entropia/sublimelight-5g/README.md

# sublimelight-5g

5th generation of illumination devices for Entropia e.V
