entropia/sublimelight-5g/hardware/input_filter.kicad_pcb

## KiCad design hardware/input_filter.kicad_pcb (2020-02-28)

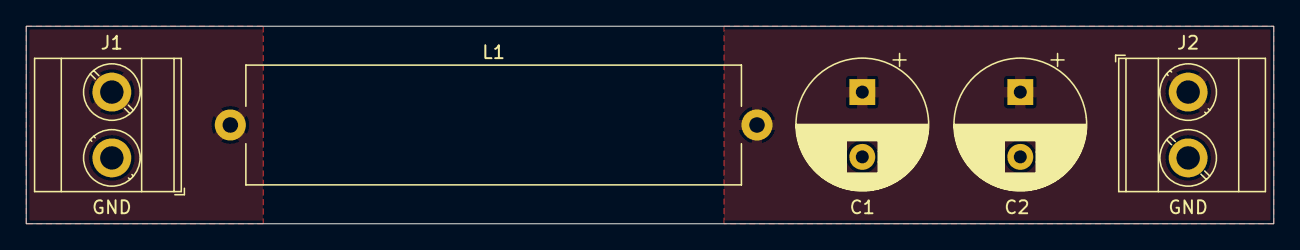
[picture p1: board input_filter.kicad_pcb from above]

Board: 2 copper layers, 96.3 x 15.2 mm, 5 parts (0 on the bottom side), 3 nets, no tracks yet.

Parts:
C1, C2: EEU-FP1V511B; CP_Radial_D10.0mm_P5.00mm
J1, J2: Conn_01x02; TerminalBlock_Phoenix_MKDS-3-2-5.08_1x02_P5.08mm_Horizontal
L1: 5252-RC; R_Axial_Power_L38.0mm_W9.0mm_P40.64mm

Connections:
/V_IN: J1.2, L1.1
/V_OUT: C1.1, C2.1, J2.1, L1.2
GND: C1.2, C2.2, J1.1, J2.2
