entropia/sublimelight-5g/hardware/sublimelight-5g.kicad_pcb

## KiCad design hardware/sublimelight-5g.kicad_pcb (2019-11-16)

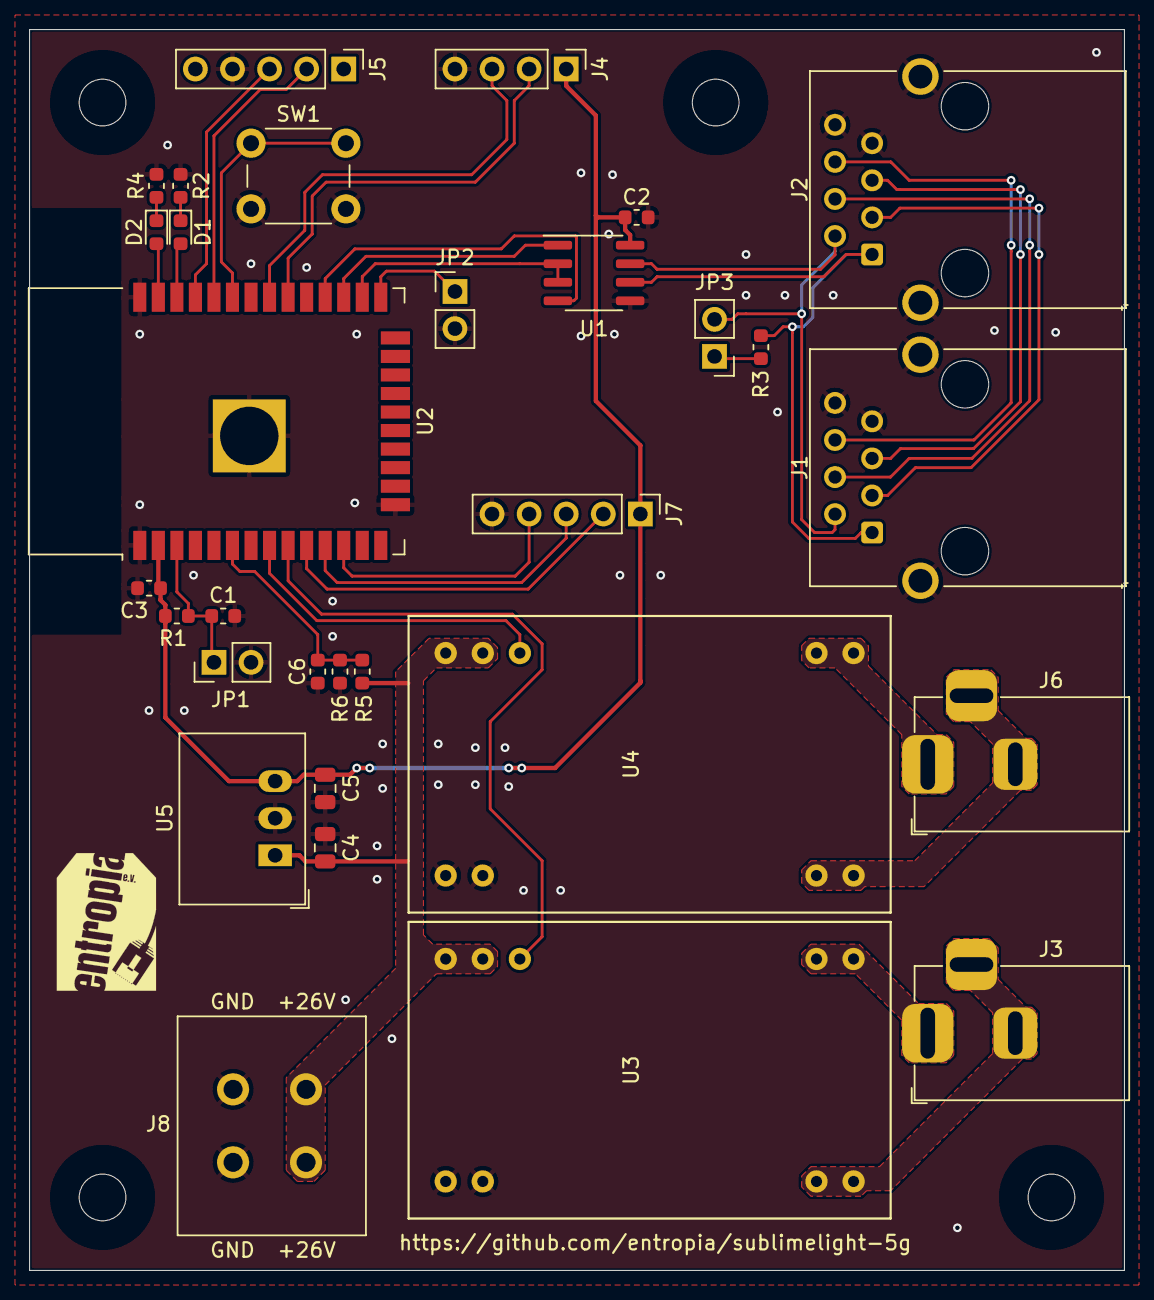
[picture p2: board sublimelight-5g.kicad_pcb from above]

Board: 2 copper layers, 75.0 x 85.0 mm, 35 parts (0 on the bottom side), 34 nets.

Parts:
C1, C2, C3, C6: 100n; C_0603_1608Metric
C4: 10u; C_0805_2012Metric
C5: 22u; C_0805_2012Metric
D1, D2: LED; LED_0603_1608Metric
H1, H2, H3, H4: MountingHole; MountingHole_3.2mm_M3
J1, J2: RJ45; RJ45_MTJ-88TX1-FSD-PGB
J3, J6: Barrel_Jack_Switch; BarrelJack_Horizontal
J4: Conn_01x04; PinHeader_1x04_P2.54mm_Vertical
J5, J7: Conn_01x05; PinHeader_1x05_P2.54mm_Vertical
J8: Conn_01x02; TBL005A-500-02
JP1, JP2, JP3: Jumper_2_Open; PinHeader_1x02_P2.54mm_Vertical
R1, R6: 10k; R_0603_1608Metric
R2, R4: 1k; R_0603_1608Metric
R3: 120R; R_0603_1608Metric
R5: 100k; R_0603_1608Metric
SW1: SW_Push; SW_PUSH_6mm
U1: ST1480ACDR; SOIC-8_3.9x4.9mm_P1.27mm
U2: ESP32-WROOM-32D; ESP32-WROOM-32
U3, U4: LDD-H; LDD_H
U5: VXO7803-1000; Converter_DCDC_RECOM_R-78E-0.5_THT

Connections:
+3V3: C2.1, C3.1, C5.1, J4.1, J7.1, R1.1, U1.8, U2.2, U5.3
/AUX_0_0: J4.2, U2.30
/AUX_0_1: J4.3, U2.31
/AUX_1_0: J7.2, U2.10
/AUX_1_1: J7.3, U2.11
/AUX_1_2: J7.4, U2.12
/DI: U1.4, U2.28
/EN: C1.1, JP1.1, R1.2, U2.3
/IO0: JP2.1, U2.25
/LED0: D1.2, U2.36
/LED1: D2.2, U2.37
/PWM_W_COLD: U2.9, U3.22
/PWM_W_WARM: U2.8, U4.22
/RJ45_3: J1.3, J2.3
/RJ45_4: J1.4, J2.4
/RJ45_5: J1.5, J2.5
/RJ45_6: J1.6, J2.6
/RO: U1.1, U2.27
/RS485_A: J1.1, J2.1, R3.1, U1.6
/RS485_B: J1.2, J2.2, JP3.2, U1.7
/RTS: U1.2, U1.3, U2.26
/TASTER: SW1.1, U2.33
/USB_RXD: J5.3, U2.35
/USB_TXD: J5.2, U2.34
/V_SENSE: C6.1, R5.2, R6.1, U2.6
/W_COLD+: J3.1, U3.13, U3.14
/W_COLD-: J3.2, J3.3, U3.11, U3.12
/W_WARM+: J6.1, U4.13, U4.14
/W_WARM-: J6.2, J6.3, U4.11, U4.12
GND: C1.2, C2.2, C3.2, C4.2, C5.2, C6.2, J1.7, J1.8, J1.SH, J2.7, J2.8, J2.SH, J4.4, J5.4, J7.5, J8.1, JP1.2, JP2.2, R2.1, R4.1, R6.2, SW1.2, U1.5, U2.1, U2.15, U2.38, U2.39, U3.1, U3.2, U4.1, U4.2, U5.2
unnamed: D1.1, R2.2
unnamed: D2.1, R4.2
unnamed: JP3.1, R3.2
VCC: C4.1, J8.2, R5.1, U3.23, U3.24, U4.23, U4.24, U5.1
