entropia/sublimelight-5g/firmware/main/wlan.h

#ifndef SL5G_WLAN_H
#define SL5G_WLAN_H

#include <esp_err.h>

#ifndef CONFIG_SL5G_WIFI_PASSWORD
#error Wifi password not set. You will brick your devices.
#endif

/**
 * Initiate connection with WLAN.
 *
 * This function returns before the connection is complete. Use event
 * handlers to wait for the connection.
 */
esp_err_t wlan_connect(void);

#endif
