entropia/sublimelight-5g/(commit log)

2019-10-19 move kicad gitignore to hardware folder
2019-10-19 add meanwell constant current led drivers
2019-10-19 create empty kicad project
    [sublimelight-5g.kicad_pcb, sublimelight-5g.sch]
2019-10-19 add meanwell constant current led driver to project
2019-10-20 add schematics backup file to gitignore
2019-10-20 begin hardware design
    [sublimelight-5g.kicad_pcb, sublimelight-5g.sch]
2019-10-20 add TBL005A-500-02 footprint
2019-10-24 add rj45 connector footprint
2019-10-24 first placement
    [sublimelight-5g.kicad_pcb, sublimelight-5g.sch]
2019-10-24 change net class parameters
    [sublimelight-5g.kicad_pcb]
2019-10-25 schematics mostly done; layout not finished yet
    [sublimelight-5g.kicad_pcb, sublimelight-5g.sch]
2019-10-26 route board
    [sublimelight-5g.kicad_pcb, sublimelight-5g.sch]
2019-10-26 add logo to board and clean up silkscreen
    [sublimelight-5g.kicad_pcb]
2019-10-29 sligthly change footprint of barel jack to match recommended footprint
    [sublimelight-5g.kicad_pcb]
2019-11-04 replace +28V power supply symbol with VCC symbol
    VCC is +26V
    [sublimelight-5g.kicad_pcb, sublimelight-5g.sch]
2019-11-16 add missing power flags in schematics
    [sublimelight-5g.sch]
2019-11-16 add logos to board
    [sublimelight-5g.kicad_pcb]
2020-01-01 Add LED test.
2020-01-01 Move test firmware to other directory, reset firmware to skeleton.
    [main.c]
2020-01-07 Remove MQTT topic prefix setting, rename board_name -> device_name.
    We use the Tasmota convention for MQTT topics, so we simply include the
    device name in the topic.
2020-02-21 Publish current IP address on stat/$device/IP.
2020-02-21 Delay rebooting after firmware update to enable HTTP response to be sent.
    [web_interface.c]
2020-02-22 Add 3D model of power supply shroud (parameterized for both types of supply).
    [shroud.scad]
2020-02-28 hardware: add input LC denoise PCB
    [input_filter.kicad_pcb, input_filter.sch]
2020-03-01 Honour configuration of broker URL instead of using hardcoded default.
    This means that after a config update we need to restart the MQTT client
    completely because we may need to connect to somewhere else. Given that
    config changes should be rare, we put no effort into restarting only when
    needed.
    [mqtt_client.c]
2020-03-06 Fix memory leak and uninitialized local variable.
    [mqtt_client.c]
2020-03-21 Make values in light_manager_state_t unsigned and not short.
    (a) It makes the types consistent with the API.
    (b) We don't need to save those four bytes.
    [light_manager.h]
2020-03-21 Add brightness and temperature settings to light_manager.
    This also requires more infrastructure to remember throwing all the
    required events. Withing the light manager, always use update_state_* to
    set values in the state. That will update the PWM module and post the
    correct event.
    [light_manager.c, light_manager.h]
2020-04-04 Implement brightness/temperature commands and status updates in the MQTT client.
2020-05-09 Add link to reboot page to go back.
    [web_interface.c]
2020-05-22 Clamp all incoming values in light_manager.
2020-05-23 Store only device ID (without sl5g prefix) in NVS config.
    We need to change this because "sl5g" is a level on its own in the new
    topic scheme.
2020-05-23 Do not shorten CMND topics in the MQTT client, match against whole topic.
    In future, topics will be more complex and the topic builder needs to
    handle them completely.
    [mqtt_client.c, topic_builder.c]
2020-05-23 Fix temperature computation for BRIGHTNESS_AUTO.
    [light_manager.c]
2020-08-30 Avoid crash when DHCP address is lost.
    TODO: Check whether this always works and is the only problem.
    [web_interface.c]
2020-09-06 Use global client handle rather than threading it through arguments.
    Who are we kidding here? There is only one MQTT client, might as well
    just access it directly.
2020-09-12 Fix subscribe_to_initial_topics: Subscribe to room/*room_name*/...
    [topic_builder.c]
2020-09-12 clamp_double: Do not assume 0 will be in the interval.
2020-09-12 Add error handling to esp_mqtt_client_publish calls.
    [mqtt_client.c]
2020-09-12 foreach_current_group_topic: Fix type warning.
    [topic_builder.c]
2020-09-22 Fix power supply shroud dimensions.
    [shroud.scad]
2021-11-07 power-supply-shroud: thicker walls and third cable hole
    [shroud.scad]
